Skydive18/OpenSkydiveAltimeter/doc/nokia-5110-lcd-front-view.jpg

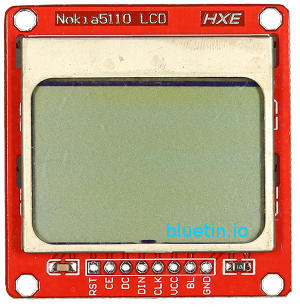
doc/nokia-5110-lcd-front-view.jpg
