Skydive18/OpenSkydiveAltimeter/layout/variants.odt

## Конфигурация звуковой системы

| L1, D2, R19, R20, R22, C16, U9 | U10 | R5 | Q4 | R17 | R18 | C14 | Подключение звонка/динамика
Активный звонок 3,3в | Нет | Нет | Нет | Да | 0R | Нет | Нет | «-» на Sound1, «+» на HWPWR
Активный звонок 5в | Да, кроме R22. R20=130K | Замкнуть выв. 5 и 6 | Нет | Да | 0R | Нет | Нет | Вместо R22, «-» на Sound1
Активный звонок 12в | Да, кроме R22. R20=47K | Замкнуть выв. 5 и 6 | Нет | Да | 0R | Нет | Нет | Вместо R22, «-» на Sound1
Пассивный динамик 1 | Нет | Нет | Нет | Да | 0R | Нет | Нет | «-» на Sound1, «+» на HWPWR
Пассивный динамик 2 | Нет | Нет | Нет | n-p-n | Да | Да | Да | «+» на Sound1, «-» на GND
Пассивный динамик 2 с регулировкой громкости | Да | Да | Нет | n-p-n | Да | Нет | Да | «+» на Sound1, «-» на GND
Простой пьезодинамик | Нет | Нет | Да | Нет | Нет | Нет | Нет | «+» на Sound1, «-» на GND
Пьезодинамик с усилителем | Нет | Нет | Нет | Да | 0R | Да | Нет | «+» на Sound1, «-» на GND
Пьезодинамик с регулировкой громкости | Да | Да | Нет | Да | 0R | Нет | Нет | «+» на Sound1, «-» на GND

### Конфигурация дисплея

| Q5 | R14 | Примечание
Nokia5110, включение подсветки лог.0, расположение GND-BL-HWPWR-SCK-MOSI-DC-SS-RESET | Нет. Замкнуть 1 и 3. | 0R | Контакт RES не подключать; соединить его на дисплее с HWPWR
Nokia5110, включение подсветки лог.1, расположение GND-BL-HWPWR-SCK-MOSI-DC-SS-RESET | Да | 0-2k | Контакт RES не подключать; соединить его на дисплее с HWPWR
Nokia5110, иное расположение контактов либо иной SPI дисплей | * | * | Подключить, учитывая разводку и полярность сигнала управления подсветкой. Контакт RES не подключать; соединить его на дисплее с HWPWR
HX1230 | Да | 0R
Nokia1201 без переходной платы | Нет. Замкнуть 1 и 3. | 330R-2K | Припаять дисплей к площадкам на обратной стороне платы
