Skydive18/OpenSkydiveAltimeter/layout/altimeter-schematic-3.2.pdf

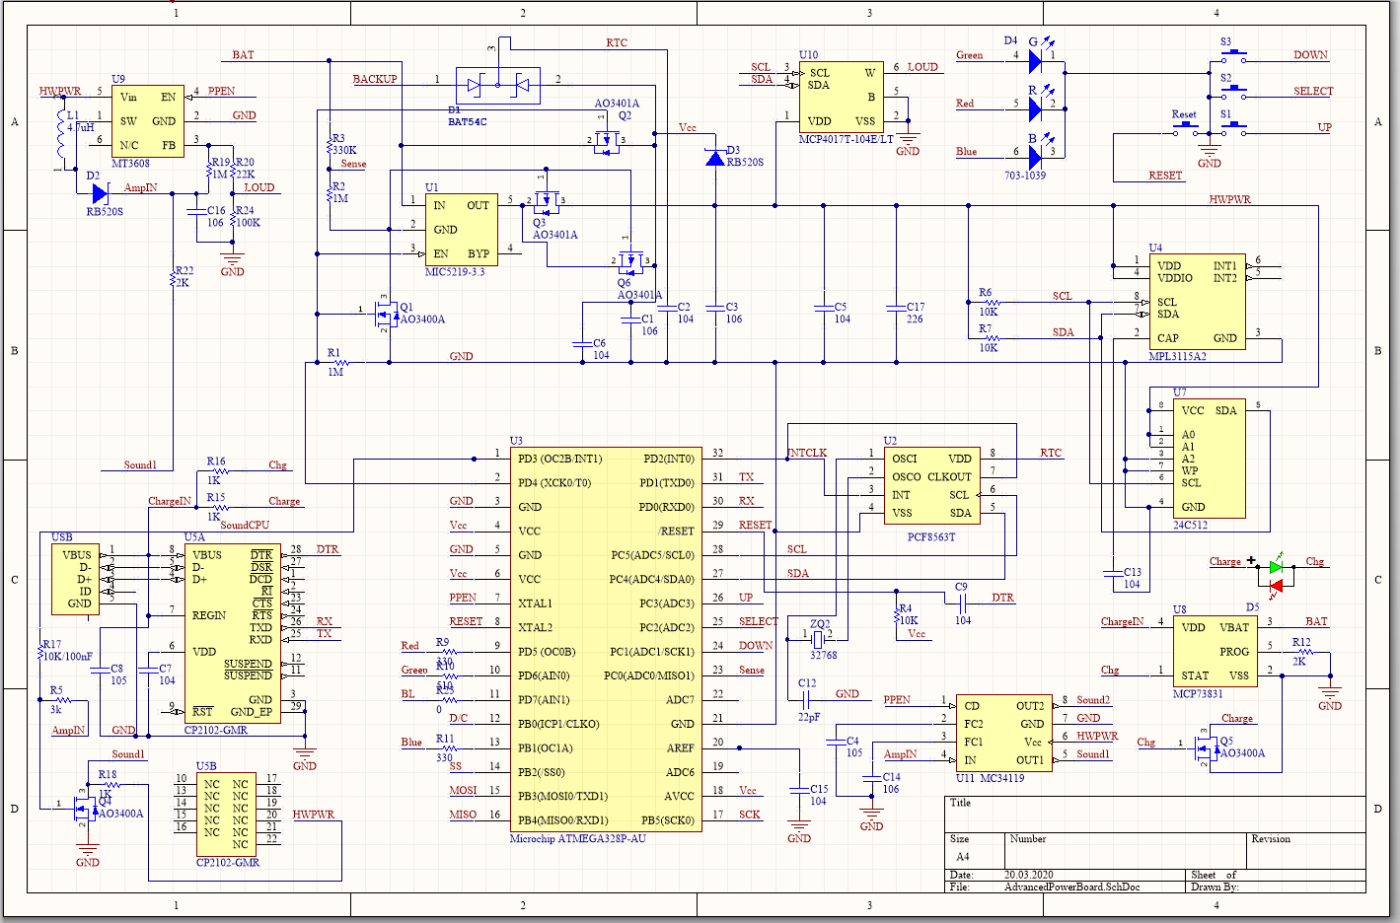
[picture p2: page 1]
