Skydive18/OpenSkydiveAltimeter/layout/altimeter-schematic-3.1.pdf

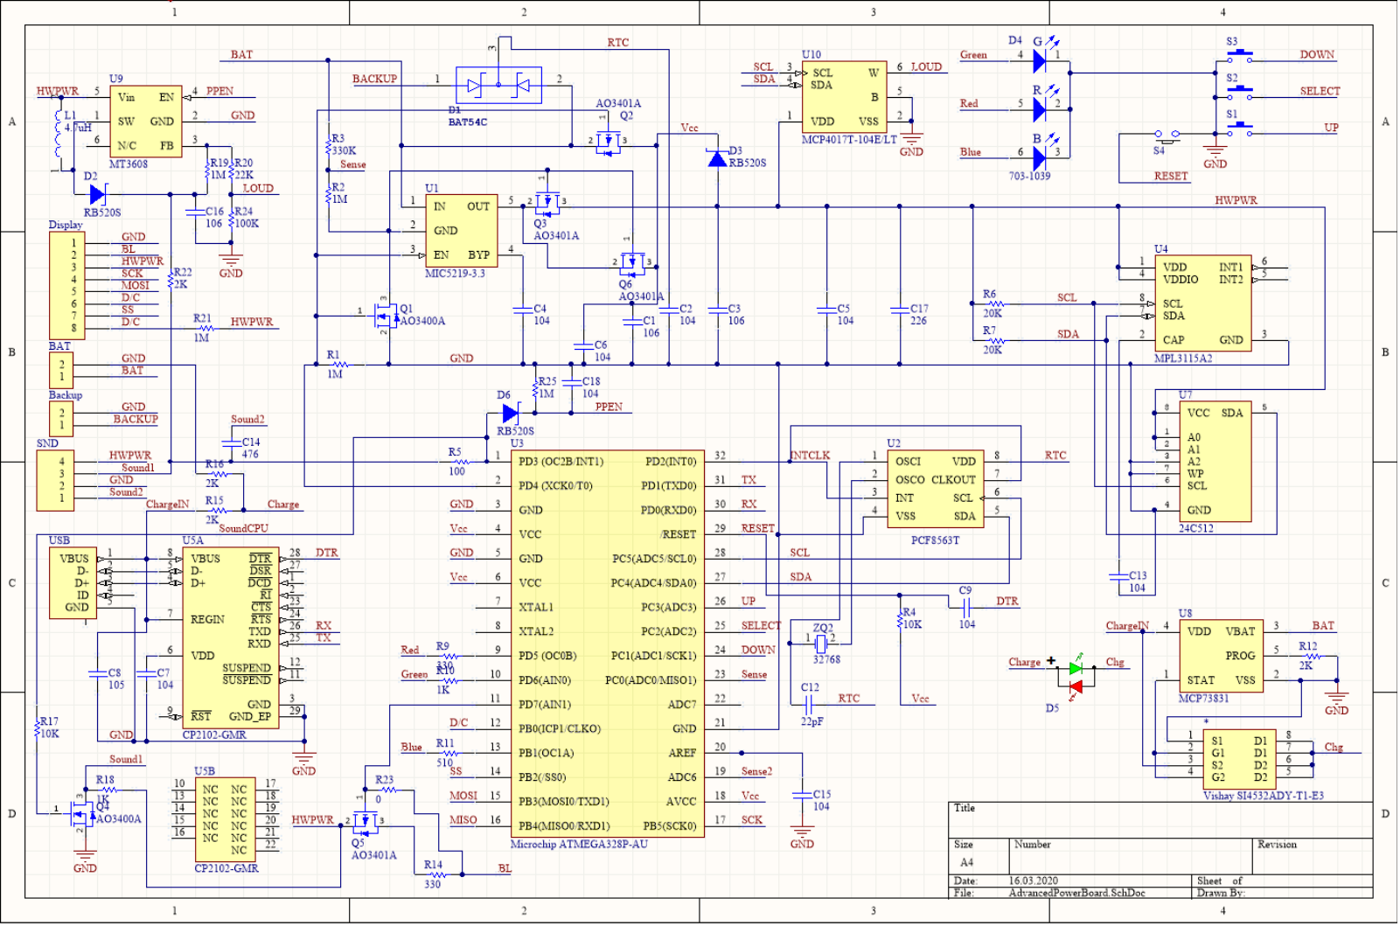
[picture p3: page 1]
