Skydive18/OpenSkydiveAltimeter/layout/altimeter-schematic-3.0.pdf

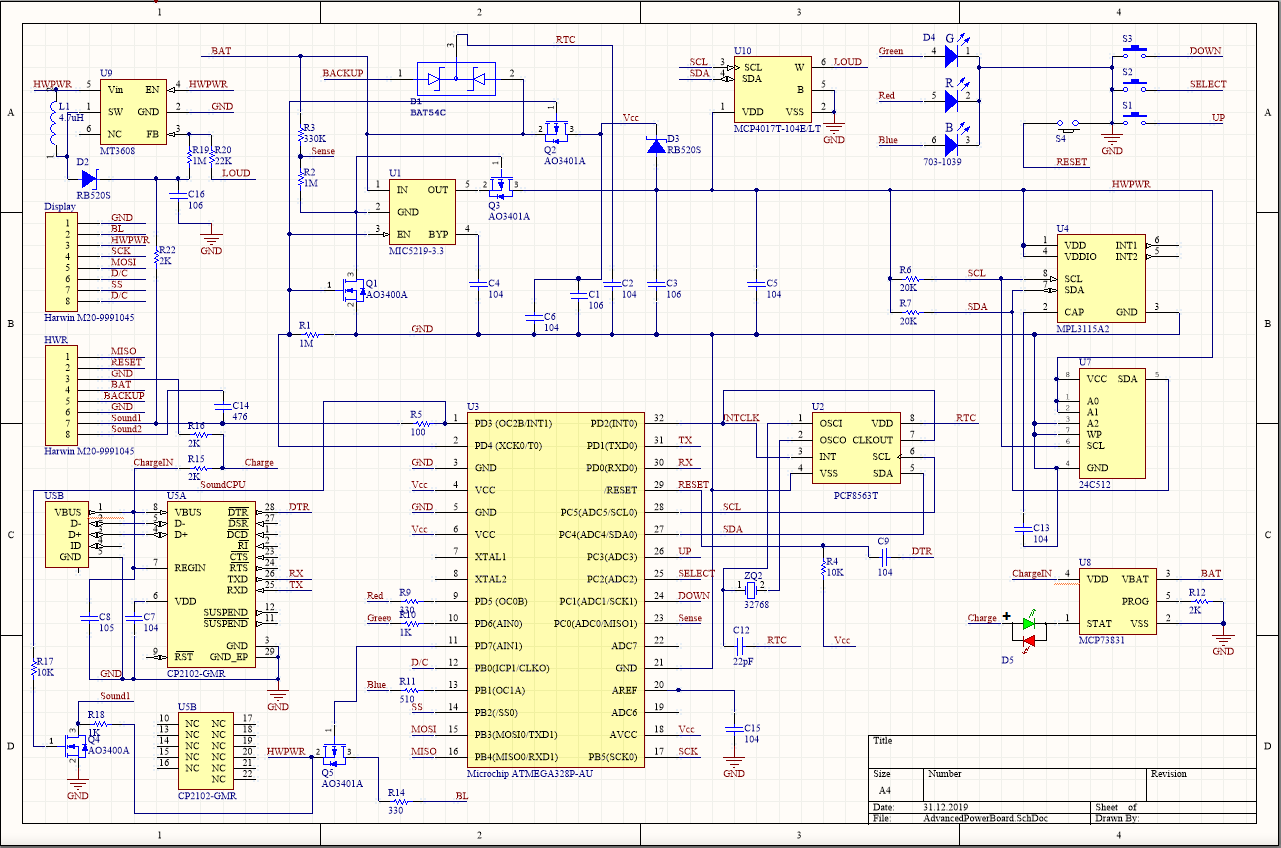
[picture p4: page 1]
