Skydive18/OpenSkydiveAltimeter/doc/AdvancedPowerController.png

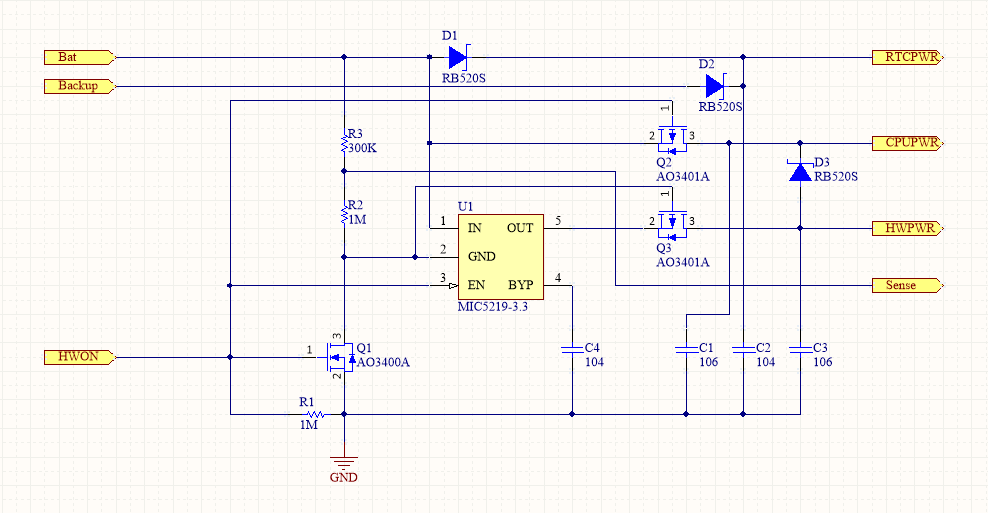
doc/AdvancedPowerController.png
