Skydive18/OpenSkydiveAltimeter/doc/SimplePowerController.png

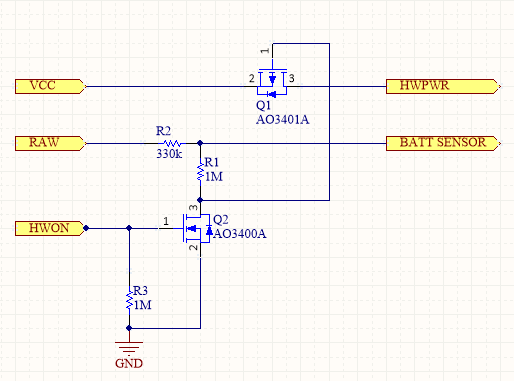
doc/SimplePowerController.png
