Skydive18/OpenSkydiveAltimeter/doc/manual.txt

!Charset UTF-8

Актуально для версии ПО 1.1

* Управление высотомером.

Включение осуществляется кнопкой Reset либо длительным удержанием
 - Средней кнопки в версии Atmega32u4 (Платформа Axx);
 - Любой кнопки в остальных версиях.
В это время мигает синий светодиод.

*** Внимание! Если после включения высотомер отображает высоту "-999" - прибор неисправен
(ошибка датчика высоты).

Вход в меню осуществляется удержанием средней кнопки. Кнопку нужно отпустить
после погасания зелёного светодиода, но до зажигания красного.

*** Внимание! Вход в меню во время прыжка (состояния "свободное падение" и "под куполом")
    приведёт к принудительному завершению записи прыжка с записью данных в логбук.
    при выходе из меню будет установлен режим "На земле".

Выключение высотомера и установка всех параметров осуществляется через меню.

* Описание некоторых параметров.

** Профиль. Поддерживаются 4 блока, в каждом из них 4 варианта настроек звуковых сигналов.
   Блоки различаются границами перехода автоматики по состояниям.
   Блок обозначается буквой, вариант - цифрой.
   S - Skydive, обычный прыжок со свободным падением
   F - Freefly. Границы те же, что и в Skydive
   С - CRW, прыжок без свободного падения (раскрытие "под хвостом")
   W - Wingsuit, прыжок в вингсьюте/трексьюте. Более низкая скорость в свободном падении.

   Для версий без звуковых сигналов профиль обозначается только буквой.

** Автоматика. Если включена, то высотомер автоматически определяет состояния
   "в наборе", "свободное падение", "под куполом", "на земле". Также в этом
   режиме ведётся запись журнала прыжков. Если этот режим выключен, то
   определение состояний, сигналы в наборе, свободном падении и под куполом
   не работают - прибор просто показывает текущую высоту.
   Конкретный режим отображается в строке состояния слева в виде цифры:
   0 - на земле
   1 - в наборе
   2,3,4 - свободное падение
   5,6,7 - под куполом
   8 - идёт инициализация автоматики (мигает красный светодиод)
   9 - автоматика выключена.

   Во всех режимах, кроме "На земле", в строке состояния рядом с номером режима показывается
   усреднённая вертикальная скорость: первая цифра - усреднение за 4с и вторая - за 16с.
   Отрицательное значение означает спуск, положительное - набор.

** Авто ноль. В этом режиме высотомер устанавливается на 0 после включения или сброса.
   В дальнейшем независимо от включения режима "авто ноль" при условии индикации высоты как "0"
   высотомер будет компенсировать медленные изменения высоты в пределах примерно +/-5м в минуту.
   После завершения прыжка в режиме "авто ноль" высотомер также попытается установить текущую
   высоту как 0. Если при этом дельта от предыдущей нулевой отметки не превысит 5 метров, то высотомер
   войдёт в режим удержания нуля, в противном случае будет показывать текущее измеренное
   значение высоты.
   При выключенном режиме "Авто ноль" потребуется ручная установка 0 после включения высотомера.

   Если при включении измеренная высота превышает 450м (относительно запомненного уровня 0),
   установка на 0 не производится независимо от настройки "авто ноль". Сброс на 0 в этом случае
   потребуется произвести вручную через меню.

** Подсветка. Может быть в трёх состояниях: авто (*), вкл (\/), выкл(-). В режиме
   "авто" подсветка включается автоматически в наборе, свободном падении и под
   куполом. Выбор запоминается между выключениями высотомера.

** Автовыкл - время до автоматического выключения высотомера. Время, когда
   открыто меню, а также время в наборе, свободном падении и под куполом
   (если включена автоматика) не учитывается. Оставшееся до автоматического
   отключения время показывается в строке состояния справа.

* Световые сигналы

** После включения
*** Мигающий красный - инициализация автоматики
*** Мигающий зелёный - автоматика готова, режим "на земле" установлен

** В наборе (если в настройках включен светодиод)
*** Вспышки красного - высота менее 300м
*** Три короткие вспышки зелёного - набрана высота 300м
*** Вспышки жёлтого - высота от 300м до 900м
*** Вспышки зелёного - высота более 900м

** В падении (если в настройках включен светодиод)
*** Синий - высота более 1500м
*** Зелёный - высота от 1500м до 1200м
*** Жёлтый - высота от 1200м до 1000м
*** Красный - высота менее 1000м

* Журнал прыжков

В верхней строке показывается общее число прыжков и через дробь - номер просматриваемого
прыжка. Через пробел - профиль, в котором был выполнен прыжок. Листается журнал прыжов конпками
"вверх" и "вниз". Средняя кнопка закрывает журнал. Если журнал пуст, вход в него невозможен.

Прыжки в журнал пишутся "по кругу", т.е. при превышении максимального размера журнала
самый старый прыжок удаляется. Выбрать его при этом не получится. Например, при максимальном размере
журнала в 30 прыжков и выполненных 35 прыжках прыжки с номерами 1-5 недоступны.

Для каждого сохранённого прыжка показывается дата и время прыжка, высоты отделения, раскрытия
(высота броска медузы) и наполнения купола, время свободного падения, средняя и максимальная
скорость свободного падения.

* Установка даты, времени, высот сигналов

Текущая изменяемая цифра отмечается стрелкой. Изменение производится кнопками "вверх" и "вниз",
переход к следующей цифре - средней кнопкой. Переход между пунктами "Ок" и "Отмена" - кнопками
"вверх" и "вниз", выбор - средней кнопкой. Таким образом, если несколько раз нажать среднюю ннопку,
будет произведён выход из меню установки параметра без сохранения изменений.

**********************************
**********************************
         ВНИМАНИЕ!!!!!!!
**********************************
**********************************
Основную часть времени высотомер проводит в режиме глубокого сна. При этом на платформе Atmega32u4,
в частности, отключается USB порт, что делает невозможным обмен данными с компьютером, прошивку
новой версии ПО и т.п. Для включения порта просто войдите в меню. На время работы меню процессор
высотмера не уходит в сон, что позволяет работать с высотомером через USB - считывать данные,
перепрошивать и т.п.
