Skydive18/OpenSkydiveAltimeter/doc/wiring_644.txt

!Charset UTF-9

https://raw.githubusercontent.com/Lauszus/Sanguino/master/package_lauszus_sanguino_index.json
