Skydive18/OpenSkydiveAltimeter/src/calibrate/readme.txt

!Charset UTF-8

Скетч предназначен для калибровки сенсора заряда батареи.

1. Полностью зарядите батарею, до индикации "Батарея заряжена" модуля заряда.
2. Залейте скетч в контроллер.
3. Отключите контроллер от компьютера.
4. Выждите 1 минуту.
5. Нажмите Reset контроллера.
6. Дождитесь мигания индикаторного светодиода зелёным.
7. Нажмите и отпустите любую кнопку.
8. Дождитесь "иллюминации" на индикаторном светодиоде.

После этого датчик заряда батареи будет откалиброван. Можно заливать в
контроллер основной скетч.
