Skydive18/OpenSkydiveAltimeter/src/altimeter/MPL.h

/* 
 MPL3115A2 Barometric Pressure Sensor Library
 */
 
#ifndef __in_mpl_h
#define __in_mpl_h

#include "Arduino.h"
#include "hwconfig.h"

#define MPL3115A2_ADDRESS 0x60 // Unshifted 7-bit I2C address for sensor

#define STATUS     0x00
#define OUT_P_MSB  0x01
#define OUT_P_CSB  0x02
#define OUT_P_LSB  0x03
#define OUT_T_MSB  0x04
#define OUT_T_LSB  0x05
#define DR_STATUS  0x06
#define OUT_P_DELTA_MSB  0x07
#define OUT_P_DELTA_CSB  0x08
#define OUT_P_DELTA_LSB  0x09
#define OUT_T_DELTA_MSB  0x0A
#define OUT_T_DELTA_LSB  0x0B
#define WHO_AM_I   0x0C
#define F_STATUS   0x0D
#define F_DATA     0x0E
#define F_SETUP    0x0F
#define TIME_DLY   0x10
#define SYSMOD     0x11
#define INT_SOURCE 0x12
#define PT_DATA_CFG 0x13
#define BAR_IN_MSB 0x14
#define BAR_IN_LSB 0x15
#define P_TGT_MSB  0x16
#define P_TGT_LSB  0x17
#define T_TGT      0x18
#define P_WND_MSB  0x19
#define P_WND_LSB  0x1A
#define T_WND      0x1B
#define P_MIN_MSB  0x1C
#define P_MIN_CSB  0x1D
#define P_MIN_LSB  0x1E
#define T_MIN_MSB  0x1F
#define T_MIN_LSB  0x20
#define P_MAX_MSB  0x21
#define P_MAX_CSB  0x22
#define P_MAX_LSB  0x23
#define T_MAX_MSB  0x24
#define T_MAX_LSB  0x25
#define CTRL_REG1  0x26
#define CTRL_REG2  0x27
#define CTRL_REG3  0x28
#define CTRL_REG4  0x29
#define CTRL_REG5  0x2A
#define OFF_P      0x2B
#define OFF_T      0x2C
#define OFF_H      0x2D

class MPL3115A2 {

// WHO_AM_I must respond with 0xc4

public:
    MPL3115A2();
    //Public Functions
    void begin(); // Gets sensor on the I2C bus.
    int readAltitude(); // Returns altitude in meters above sealevel. Ex: 1638
    void zero(); // reset altitude to zero
#ifdef TEST_JUMP_ENABLE
    void debugPrint();
#endif
private:
    //Private Functions
    int ground_altitude;
    void toggleOneShot();

#ifdef TEST_JUMP_ENABLE
    bool isDebug;
    int readPtr;
    int debugAltitude;
#endif
};

#endif
