Skydive18/OpenSkydiveAltimeter/(commit log)

2019-10-03 Added debug line (raw voltage, battery voltage, temperature)
2019-10-03 Change batt sensor calibration
2019-10-07 Refine menu system and power management scheme
2019-10-09 Added mode change manager Added LED support in airplane and freefall
2019-10-09 Add prefill mode led blink
2019-10-09 Fixed LED PWM with power-down mode conflict
    [altimeter.ino]
2019-10-11 Allow reset to zero altitude only when it is safe
    [altimeter.ino]
2019-10-12 Added auto backlight in jump modes (configurable) Added auto poweroff (configurable)
2019-10-17 Menu system rearrange
    Get rid of u8g2 menus. They are smart, but
    require too much progmem.
    [altimeter.ino, display.h]
2019-10-18 Fixed loss usb conn after startup Fixed setTime menu entry
    [altimeter.ino]
2019-10-18 Changed menu font, minor rework
    [altimeter.ino]
2019-10-18 Added initialization sketch (buggy)
    [altimeter.ino, calibrate.ino, hwconfig.h]
2019-10-19 Fixed bat calibration and logbook
    [altimeter.ino, calibrate.ino]
2019-10-19 Added doc for calibration sketch
2019-10-19 Fixed memory dump formatting
    Fixed memory dump formatting.
    Cnahged formatting in date and time
    settings menu.
    [altimeter.ino]
2019-10-21 Reworked display refresh in MODE_ON_EARTH
    [altimeter.ino, calibrate.ino, hwconfig.h]
2019-10-21 Add zero drift correction
    [altimeter.ino]
2019-10-22 Optimize zero drift compensation
    [altimeter.ino]
2019-10-22 On poweron, set to zero if near it
2019-10-22 More optimization and bugfixes
    [altimeter.ino]
2019-10-22 Fix bug in average speed calculation
    [altimeter.ino]
2019-10-23 More approach for HX1230 HW 3-wire SPI
2019-10-25 Fix logbook debug param builder
    [altimeter.ino]
2019-11-18 Change wiring and turn-on sequence for 32u4 Change docs Use idle mode instead of delay when PWM is in use
2019-11-19 Change wiring, introduce active buzzer
    [altimeter.ino, calibrate.ino, display.h, flash.cpp, flash.h, hwconfig.h, snd.cpp]
2019-11-20 Update calibration sketch documentation
2019-11-20 Update docs, added timer2 code
2019-11-23 Fixed turn-on sequence for 32u4
    [altimeter.ino]
2019-11-27 Move HX1230 to hardware SPI
2019-11-28 Small optimization, change wiring for 32u4
2019-11-28 Added buzz on passive speaker
    [hwconfig.h, snd.cpp, snd.h]
2019-12-01 Change wiring for 32u4
2019-12-03 Added schematic and PCB
2019-12-04 Fix power consumption bug in passive snd subsystem
    [snd.cpp]
2019-12-04 Not working, just to keep it here
    [snd.cpp, snd.h]
2019-12-08 Fix timeout in logbook viewer
    [altimeter.ino]
2019-12-09 Change wiring documentation
2019-12-10 Implement sounds while freefall, fix logbook
    [MPL.cpp, MPL.h, altimeter.ino, logbook.cpp, snd.cpp]
2019-12-11 Fix bug in settings menu item order
    [altimeter.ino]
2019-12-17 Add URL for cp2102 driver
2019-12-27 Refactoring stage I
2020-01-07 Add config for crystal-less 328p board
2020-01-09 Add doc for pcb variants
2020-02-06 Fix zero alt save - pcf8563
    [RTC.cpp, hwconfig.h]
2020-02-07 Fix alarm pcf8563, set comspeed 9600
    [RTC.cpp, calibrate.ino, hwconfig.h]
2020-02-11 Set i2c speed to 400k when possible
2020-03-03 Move to current library versions Changes to state machine detecting "under parachute" condition Refactoring
2020-03-04 Removed datasheets. Fixed several bugs.
    [altimeter.ino, hwconfig.h, messages_en.h, messages_ru.h]
2020-03-05 LED blinks while dumping memory
2020-03-09 Change batt calibration
2020-03-10 changed bootloader in boards.txt
2020-03-11 Fix fuses in bootloader
2020-03-12 Remove battery debug data
2020-03-15 Add hardware reset capability when restart
    [altimeter.ino, common.cpp, common.h]
2020-03-15 Fix backlight in "+" mode
    [altimeter.ino]
2020-03-16 Added schematic for board rev.3.1
2020-03-16 Bugfix, added font utilites
    [altimeter.ino]
2020-03-16 Fix bug in powerOff
    [altimeter.ino, power.cpp]
2020-03-18 Fix bugs, add auto-repeat in some menus
    [altimeter.ino, automatics.cpp, hwconfig.h, kbd_led.cpp, kbd_led.h]
2020-03-18 Change batt sensor algorithm
2020-03-22 Make use internal AREF in batt sensor
2020-03-23 Added path info for boards.txt
2020-03-23 Fix default flash size for BH32
    [hwconfig.h]
