Skydive18/OpenSkydiveAltimeter/(notices)

Notices in the files:
src/testflash/flash.cpp:
This library is free software: you can redistribute it and/or modify it under
the terms of the GNU Lesser General Public License as published by the Free
